NewsanLab/K9-Trainner/Hardware/ShielArchiK9V2.step

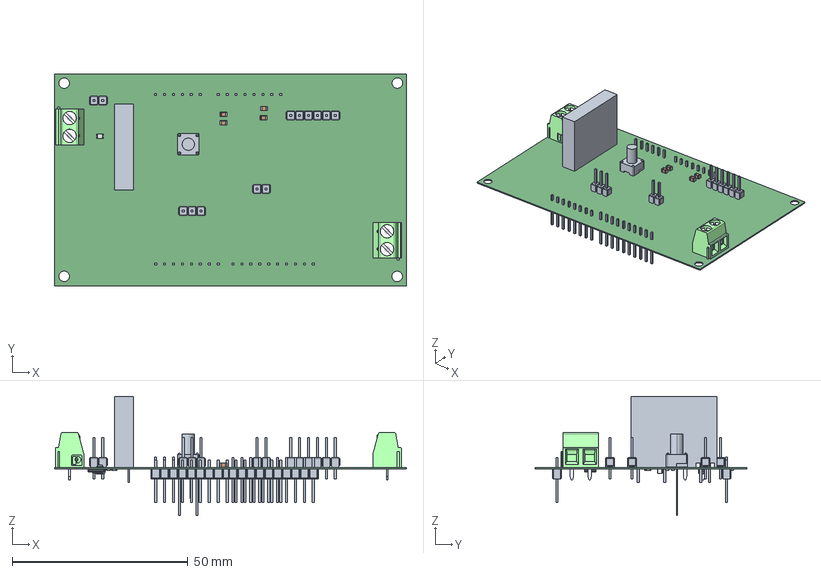
[picture p6: CAD file, 2024-08-16]
Hardware/ShielArchiK9V2.step
100.2 x 60.4 x 33.9 mm
Extruded x 19
mkdsn_1.5-2-5.08 x 2
Bourns Logo
826646-2--3DModel-STEP-1 x 2
H3MB-052D Rel石olido
Murata Logo 3 x 5
826646-3--3DModel-STEP-1
1N4148W-TP
826630-8--3DModel-STEP-1 x 2
1-826629-0--3DModel-STEP-1
826646-6--3DModel-STEP-1 x 2
