NewsanLab/K9-Trainner/Mecánica/.STL/PortaPlacas2.STL

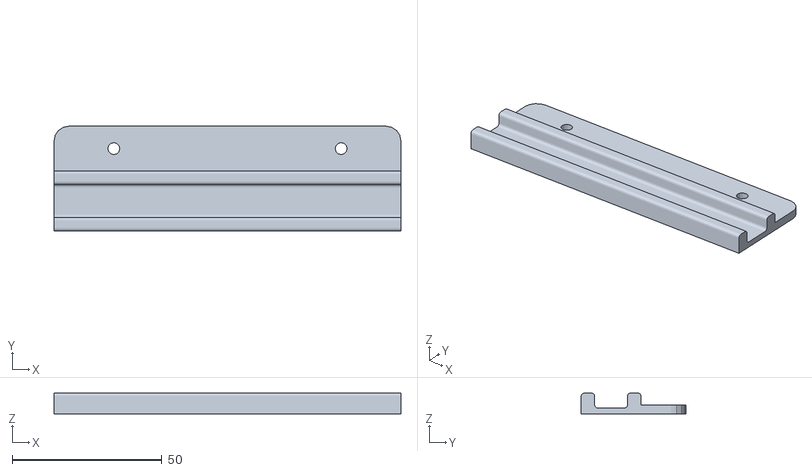
[picture p7: CAD file, 2024-08-16]
Mecánica/.STL/PortaPlacas2.STL
116.0 x 35.0 x 7.00
