NewsanLab/K9-Trainner/Mecánica/DXF/MDF-5.5mm.DXF

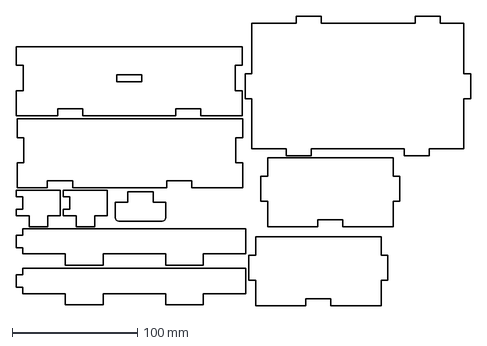
[picture p8: CAD file, 2024-08-16]
Mecánica/DXF/MDF-5.5mm.DXF
362.4 x 230.5 mm
