NewsanLab/K9-Trainner/Mecánica/SolidWorks/resorte.SLDPRT

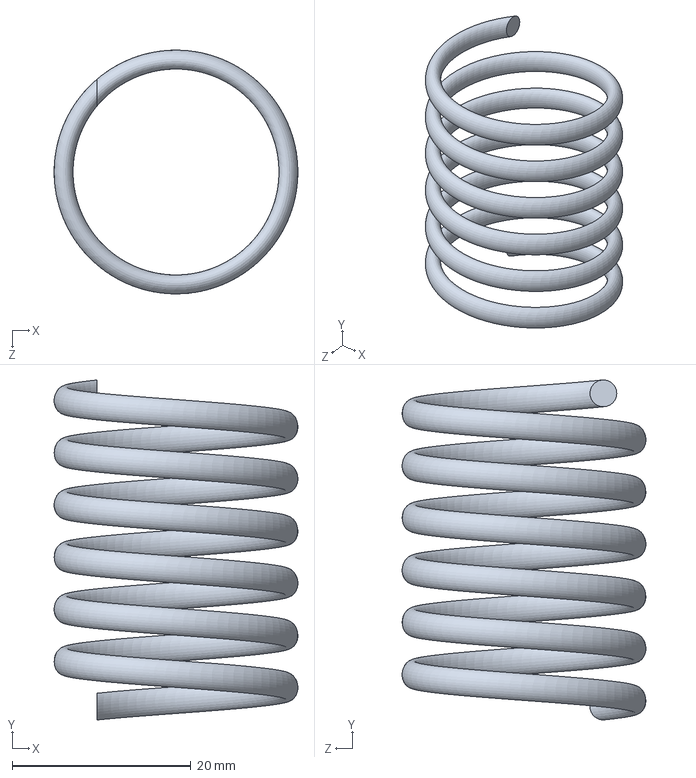
[picture p9: CAD file, 2024-08-16]
Mecánica/SolidWorks/resorte.SLDPRT
27.2 x 38.0 x 27.2 mm
