NewsanLab/K9-Trainner/Mecánica/.STL/PortaPlacas.STL

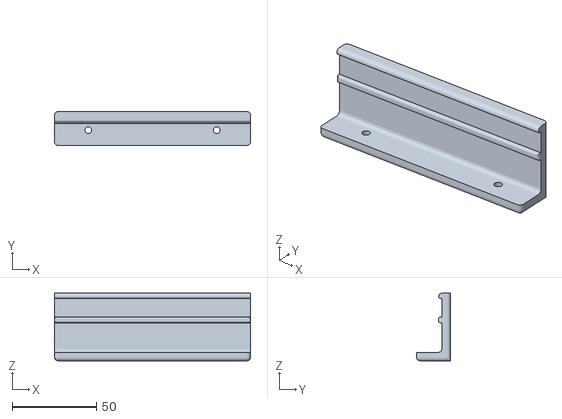
[picture p10: CAD file, 2024-08-16]
Mecánica/.STL/PortaPlacas.STL
116.0 x 20.0 x 40.0
