NewsanLab/K9-Trainner/Mecánica/DXF/Acrilico-3mm.DXF

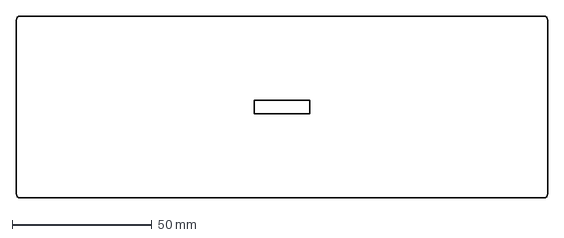
[picture p11: CAD file, 2024-08-16]
Mecánica/DXF/Acrilico-3mm.DXF
190.0 x 65.0 mm
