NewsanLab/K9-Trainner/Mecánica/SolidWorks/Angulos_Acrilico10mm.SLDPRT

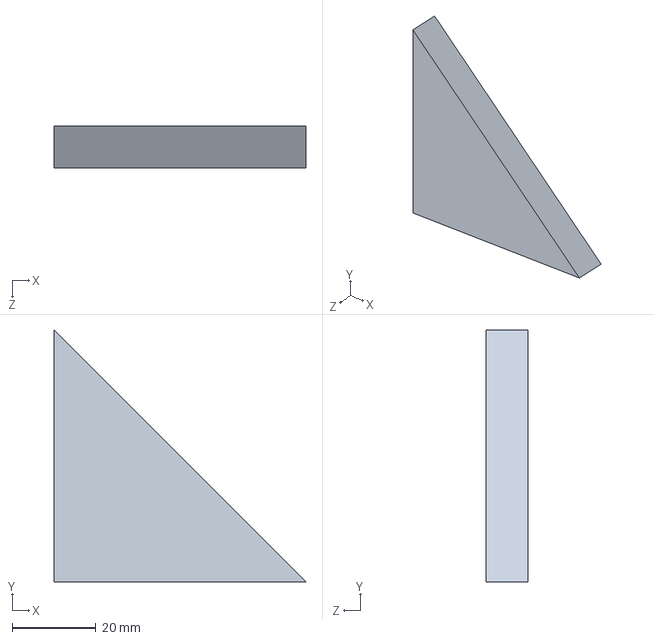
[picture p12: CAD file, 2024-08-16]
Mecánica/SolidWorks/Angulos_Acrilico10mm.SLDPRT
60.0 x 60.0 x 10.0 mm
