NewsanLab/K9-Trainner/Mecánica/.STL/PortaPilas.STL

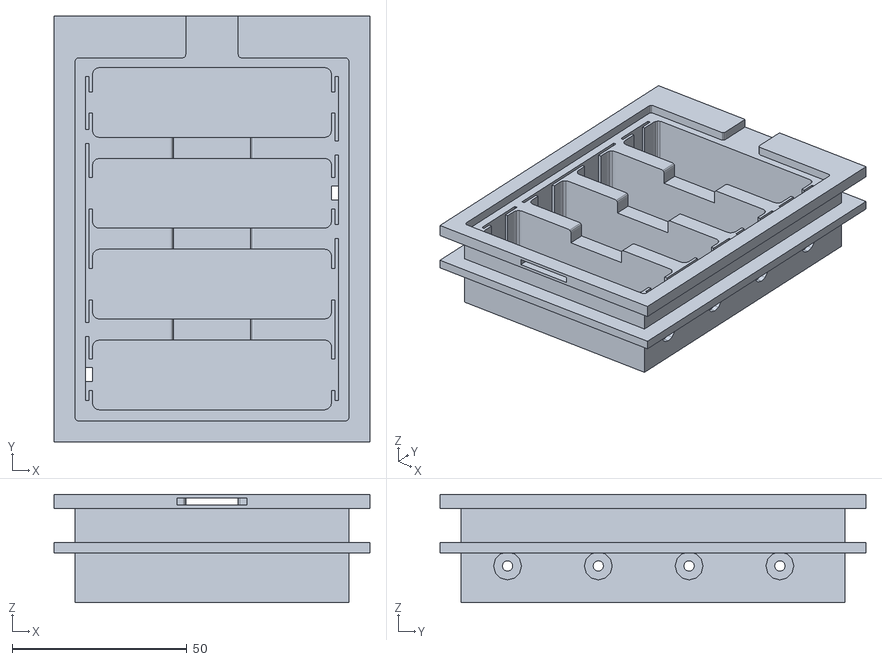
[picture p13: CAD file, 2024-08-16]
Mecánica/.STL/PortaPilas.STL
90.5 x 122.0 x 31.0
