NewsanLab/K9-Trainner/Mecánica/DXF/Acrilico-10mm.DXF

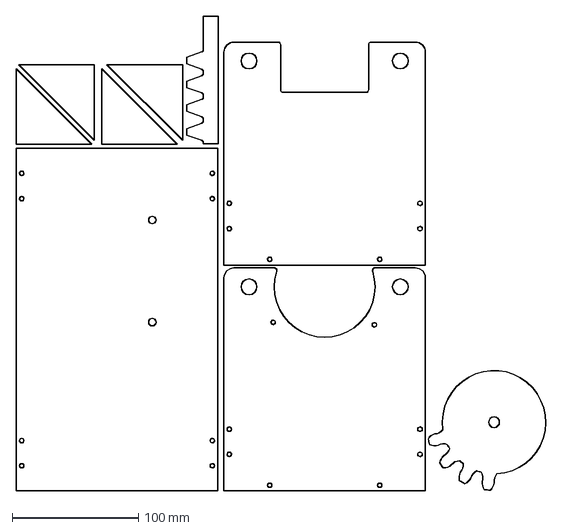
[picture p14: CAD file, 2024-08-16]
Mecánica/DXF/Acrilico-10mm.DXF
423.4 x 376.9 mm
