NewsanLab/K9-Trainner/Mecánica/SolidWorks/INTERRUPTOR SWITCH.SLDPRT

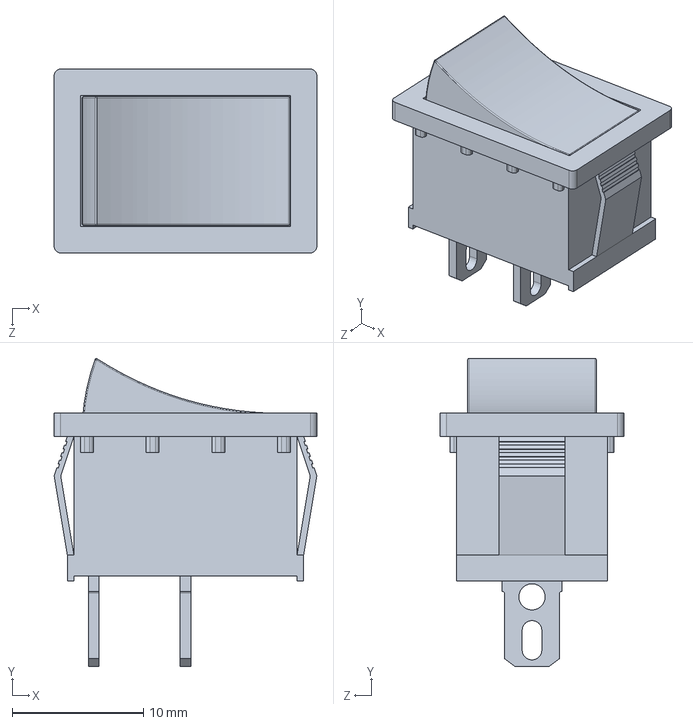
[picture p15: CAD file, 2024-08-16]
Mecánica/SolidWorks/INTERRUPTOR SWITCH.SLDPRT
20.0 x 23.4 x 14.0 mm
