NewsanLab/K9-Trainner/Mecánica/DXF/MDF-9mm.DXF

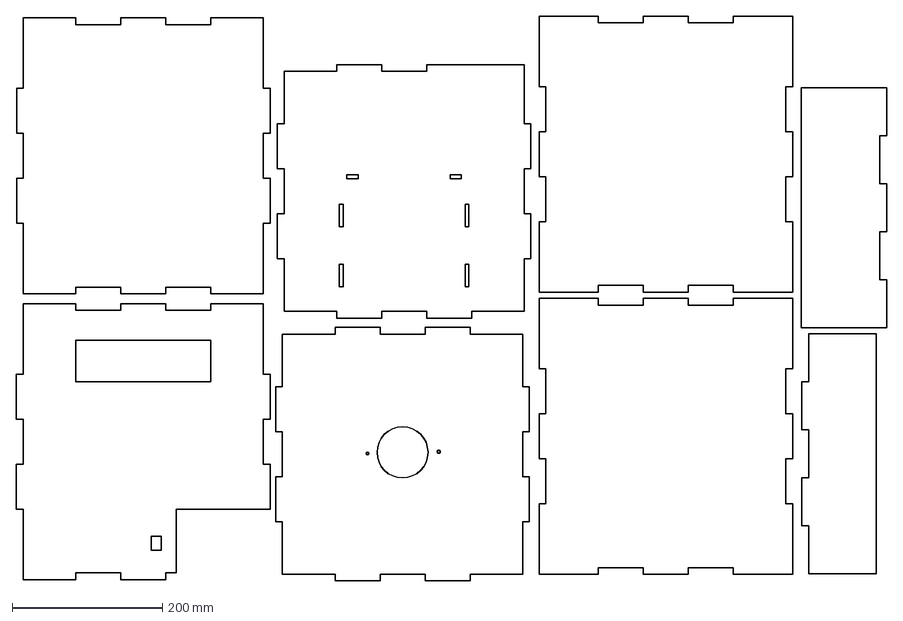
[picture p16: CAD file, 2024-08-16]
Mecánica/DXF/MDF-9mm.DXF
1160.0 x 752.8 mm
