NewsanLab/K9-Trainner/Mecánica/SolidWorks/Portapelota_Impreso3D.SLDPRT

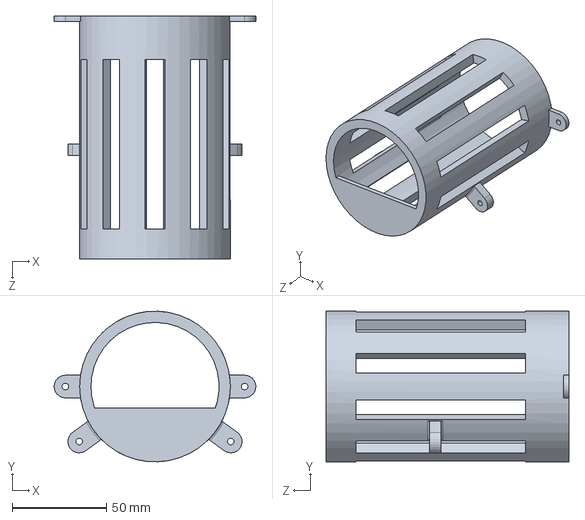
[picture p17: CAD file, 2024-08-16]
Mecánica/SolidWorks/Portapelota_Impreso3D.SLDPRT
107.1 x 79.9 x 129.0 mm
