NewsanLab/K9-Trainner/Mecánica/SolidWorks/Baterias.SLDPRT

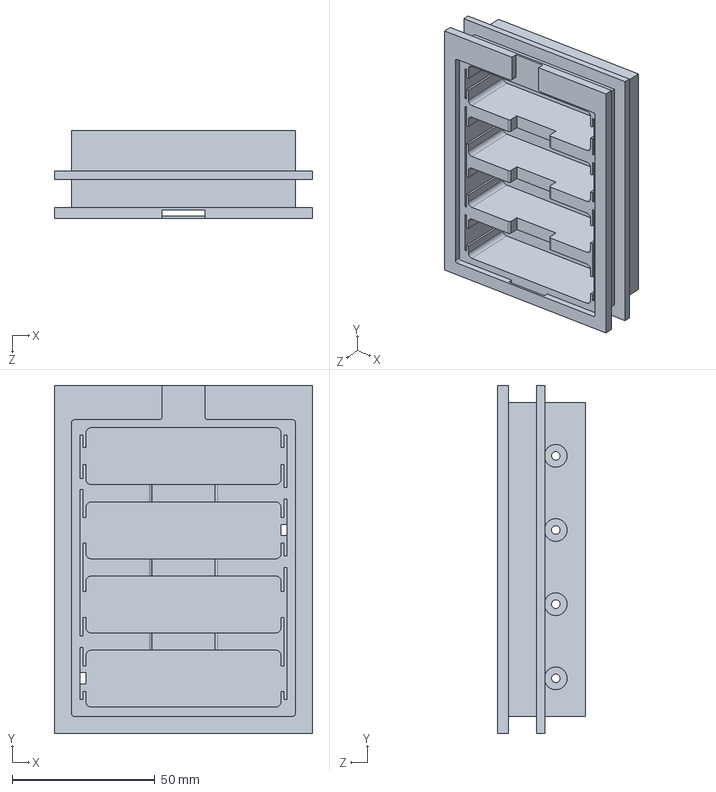
[picture p18: CAD file, 2024-08-16]
Mecánica/SolidWorks/Baterias.SLDPRT
90.5 x 122.0 x 31.0 mm
