NewsanLab/K9-Trainner/Mecánica/SolidWorks/Eje_final.SLDPRT

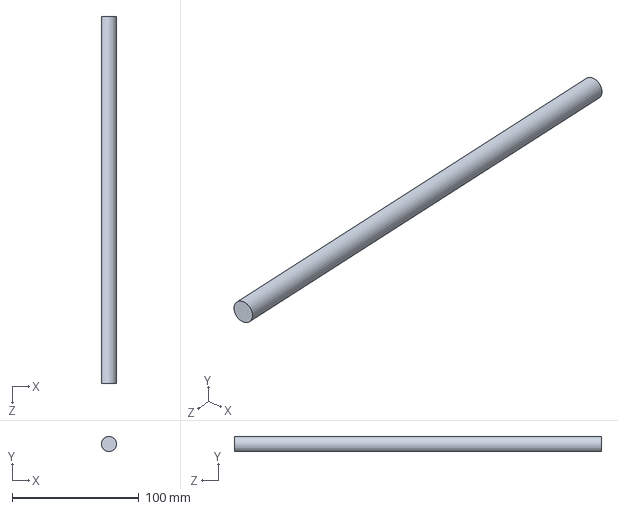
[picture p19: CAD file, 2024-08-16]
Mecánica/SolidWorks/Eje_final.SLDPRT
12.0 x 12.0 x 290.0 mm
