NewsanLab/K9-Trainner/Mecánica/SolidWorks/Portacremallera_Impreso3D.SLDPRT

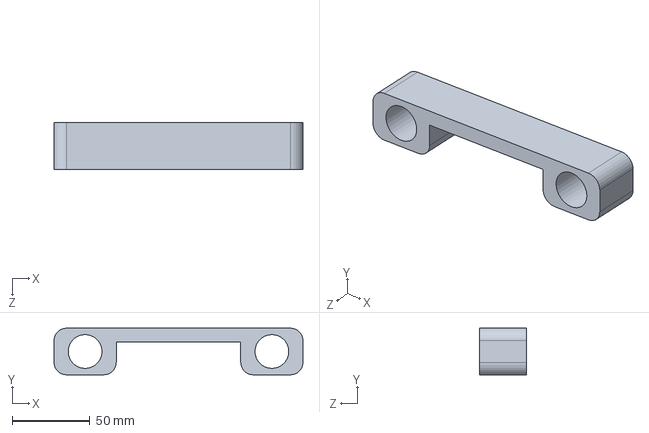
[picture p20: CAD file, 2024-08-16]
Mecánica/SolidWorks/Portacremallera_Impreso3D.SLDPRT
160.0 x 30.0 x 30.0 mm
