NewsanLab/K9-Trainner/Mecánica/SolidWorks/Base_Acrilico10mm.SLDPRT

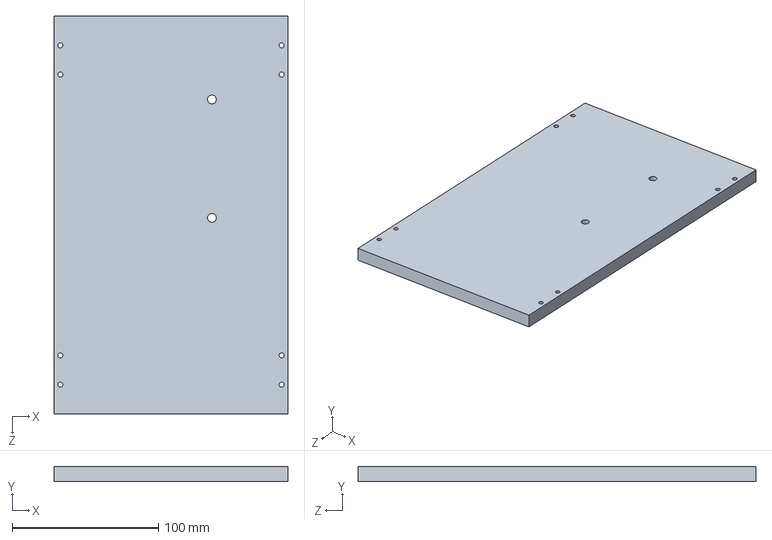
[picture p21: CAD file, 2024-08-16]
Mecánica/SolidWorks/Base_Acrilico10mm.SLDPRT
160.0 x 10.0 x 272.0 mm
