NewsanLab/K9-Trainner/Mecánica/SolidWorks/Cajon.trasero_MDF5.5mm.SLDPRT

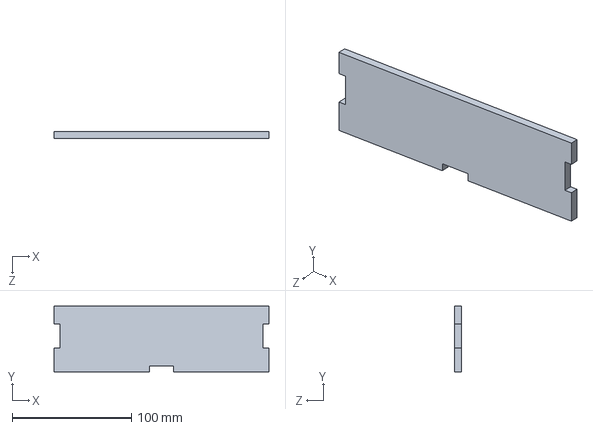
[picture p22: CAD file, 2024-08-16]
Mecánica/SolidWorks/Cajon.trasero_MDF5.5mm.SLDPRT
180.0 x 55.0 x 5.50 mm
