NewsanLab/K9-Trainner/Mecánica/SolidWorks/Estructura delantera_Acrilico10mm.SLDPRT

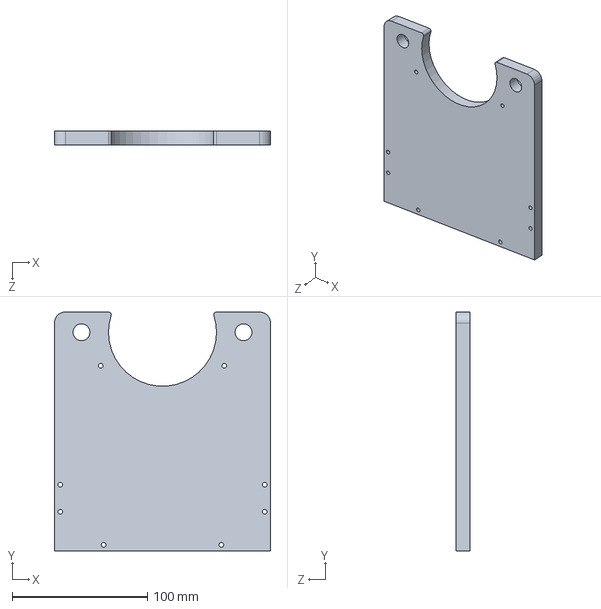
[picture p23: CAD file, 2024-08-16]
Mecánica/SolidWorks/Estructura delantera_Acrilico10mm.SLDPRT
160.0 x 177.0 x 10.0 mm
