NewsanLab/K9-Trainner/Mecánica/SolidWorks/Buje.SLDPRT

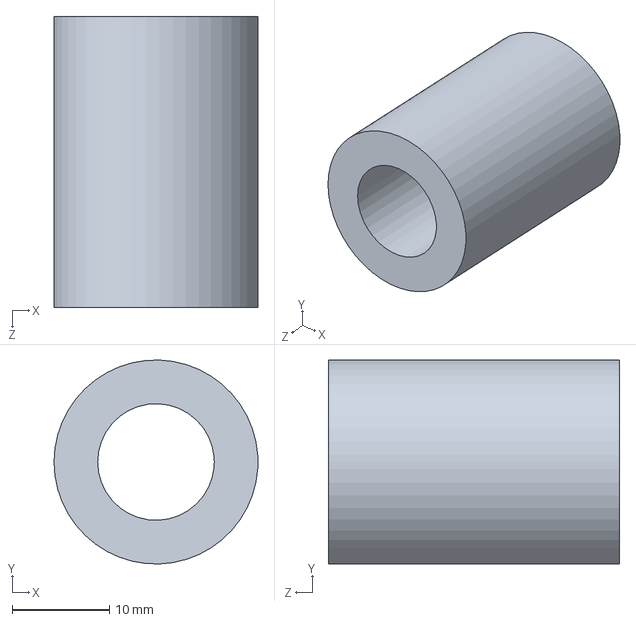
[picture p24: CAD file, 2024-08-16]
Mecánica/SolidWorks/Buje.SLDPRT
21.0 x 21.0 x 30.0 mm
