NewsanLab/K9-Trainner/Mecánica/SolidWorks/Cajon.manija_MDF5.5mm.SLDPRT

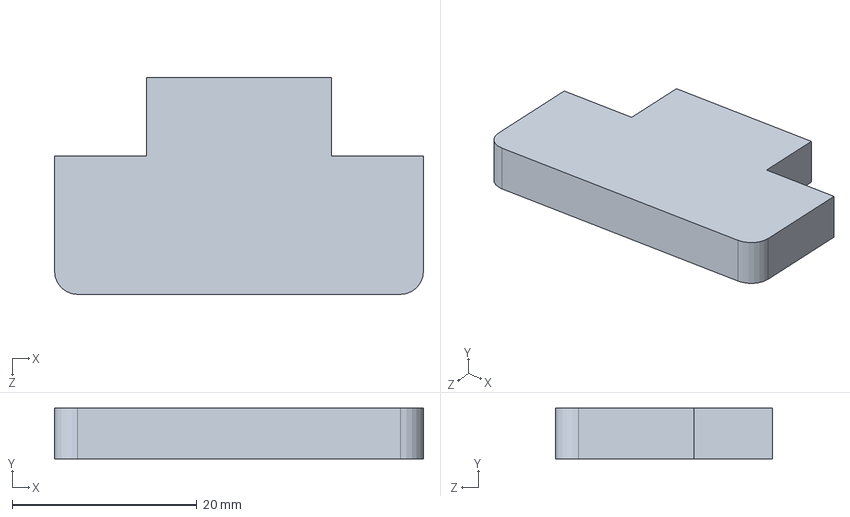
[picture p25: CAD file, 2024-08-16]
Mecánica/SolidWorks/Cajon.manija_MDF5.5mm.SLDPRT
40.0 x 5.50 x 23.5 mm
