NewsanLab/K9-Trainner/Mecánica/SolidWorks/Cajon.lateral_MDF5.5mm.SLDPRT

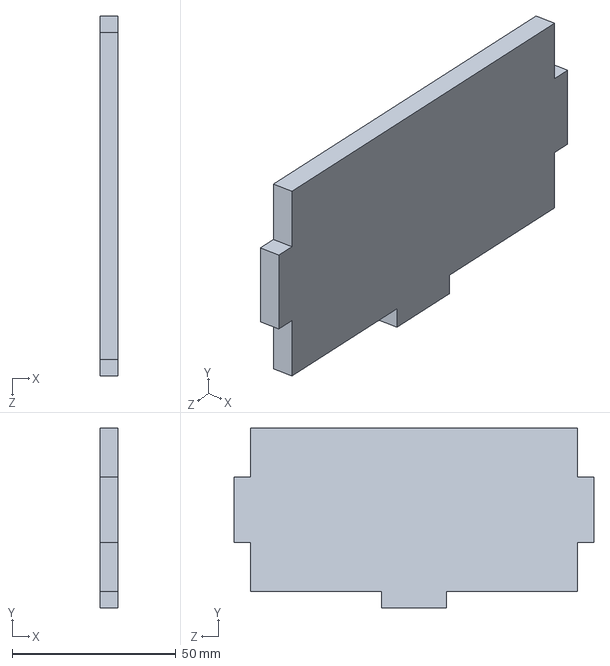
[picture p26: CAD file, 2024-08-16]
Mecánica/SolidWorks/Cajon.lateral_MDF5.5mm.SLDPRT
5.50 x 55.0 x 110.0 mm
