NewsanLab/K9-Trainner/Mecánica/SolidWorks/Cremallera_Acrilico10mm.SLDPRT

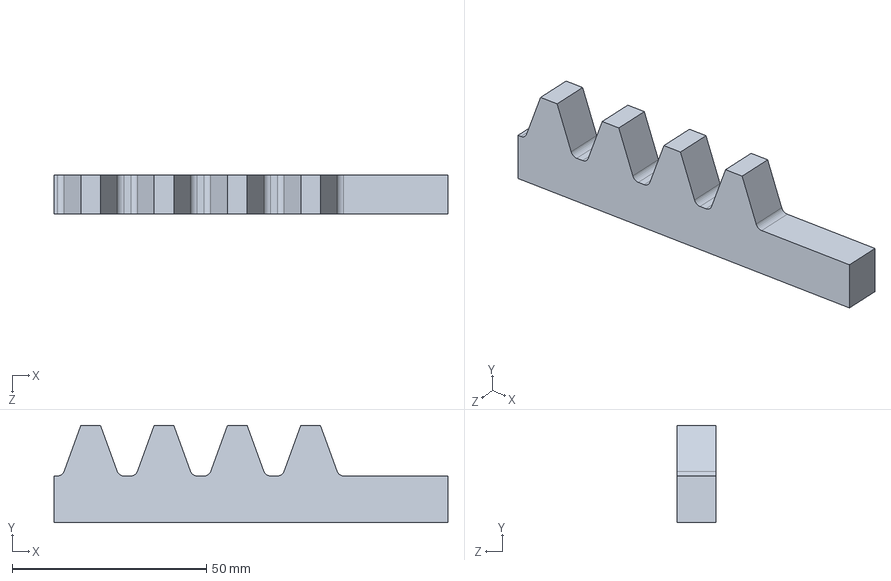
[picture p27: CAD file, 2024-08-16]
Mecánica/SolidWorks/Cremallera_Acrilico10mm.SLDPRT
101.3 x 25.0 x 10.0 mm
