NewsanLab/K9-Trainner/Mecánica/SolidWorks/CubreElectrónica.mdf.SLDPRT

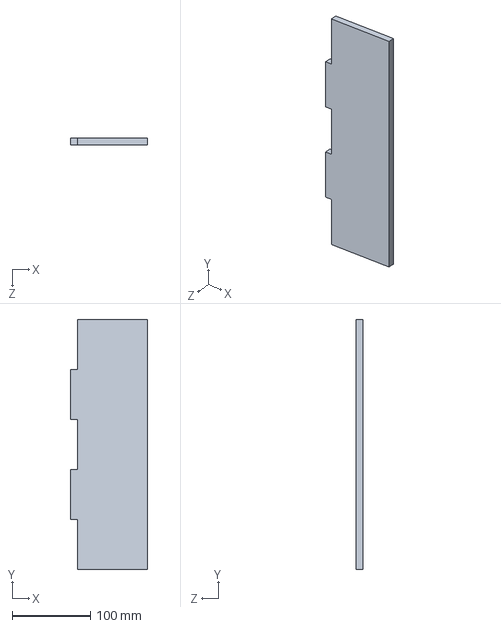
[picture p29: CAD file, 2024-08-16]
Mecánica/SolidWorks/CubreElectrónica.mdf.SLDPRT
99.0 x 320.0 x 9.00 mm
