NewsanLab/K9-Trainner/Mecánica/SolidWorks/CAJA_LATERAL3 _MDF9mm.SLDPRT

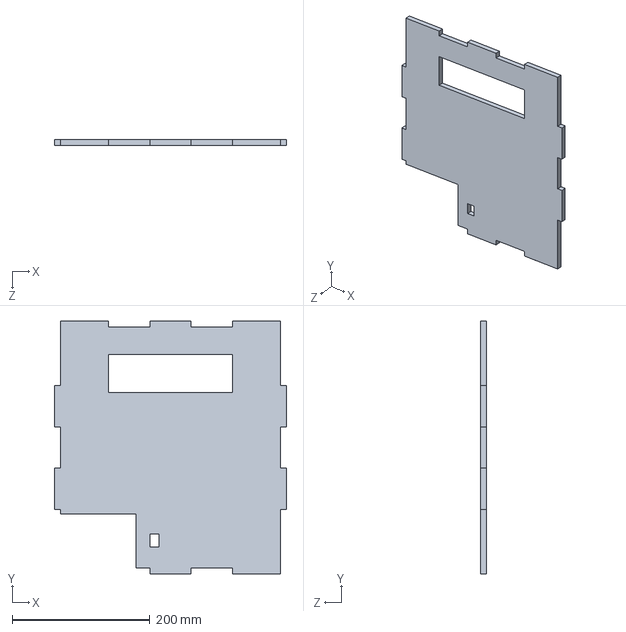
[picture p31: CAD file, 2024-08-16]
Mecánica/SolidWorks/CAJA_LATERAL3 _MDF9mm.SLDPRT
338.0 x 368.0 x 9.00 mm
