NewsanLab/K9-Trainner/Mecánica/SolidWorks/Cajon.base_MDF5.5mm.SLDPRT

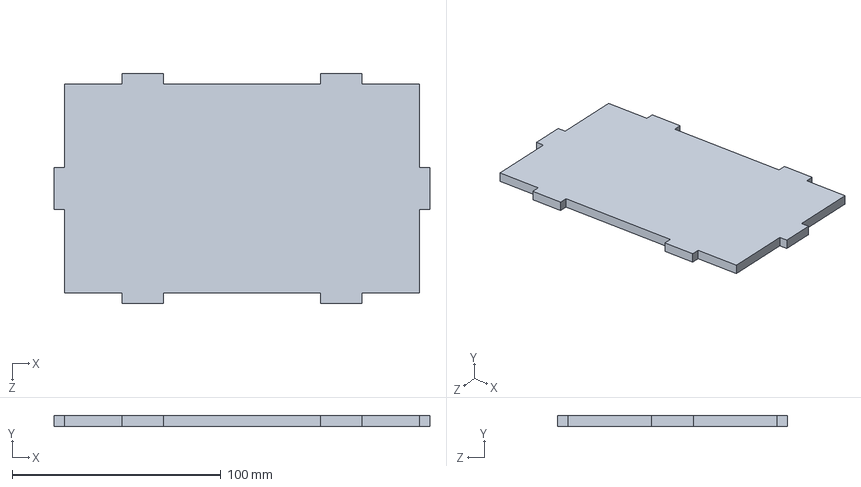
[picture p32: CAD file, 2024-08-16]
Mecánica/SolidWorks/Cajon.base_MDF5.5mm.SLDPRT
180.0 x 5.50 x 110.0 mm
