NewsanLab/K9-Trainner/Mecánica/SolidWorks/Cajon.frente_Acrilico3mm.SLDPRT

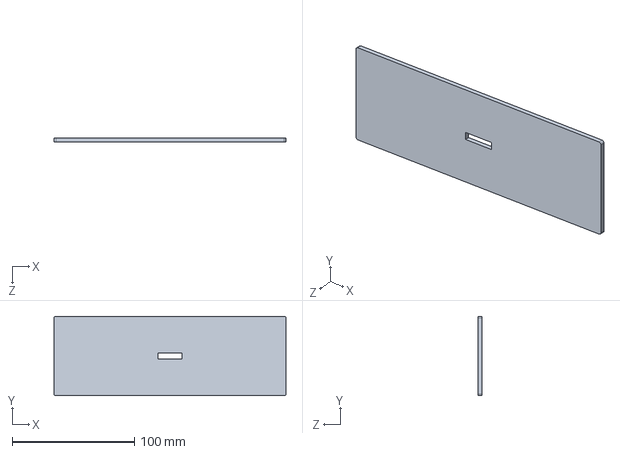
[picture p33: CAD file, 2024-08-16]
Mecánica/SolidWorks/Cajon.frente_Acrilico3mm.SLDPRT
190.0 x 65.0 x 3.00 mm
