NewsanLab/K9-Trainner/Mecánica/SolidWorks/Piñon_Acrilico10mm.SLDPRT

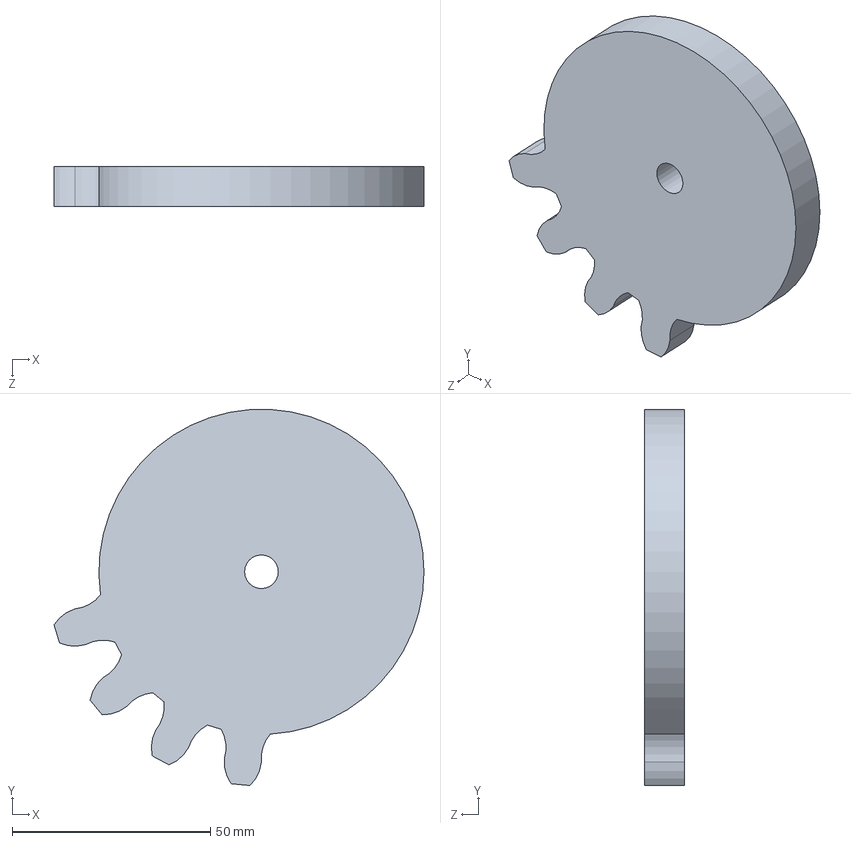
[picture p34: CAD file, 2024-08-16]
Mecánica/SolidWorks/Piñon_Acrilico10mm.SLDPRT
93.3 x 94.9 x 10.0 mm
