NewsanLab/K9-Trainner/Mecánica/SolidWorks/CubreElectrónica2.SLDPRT

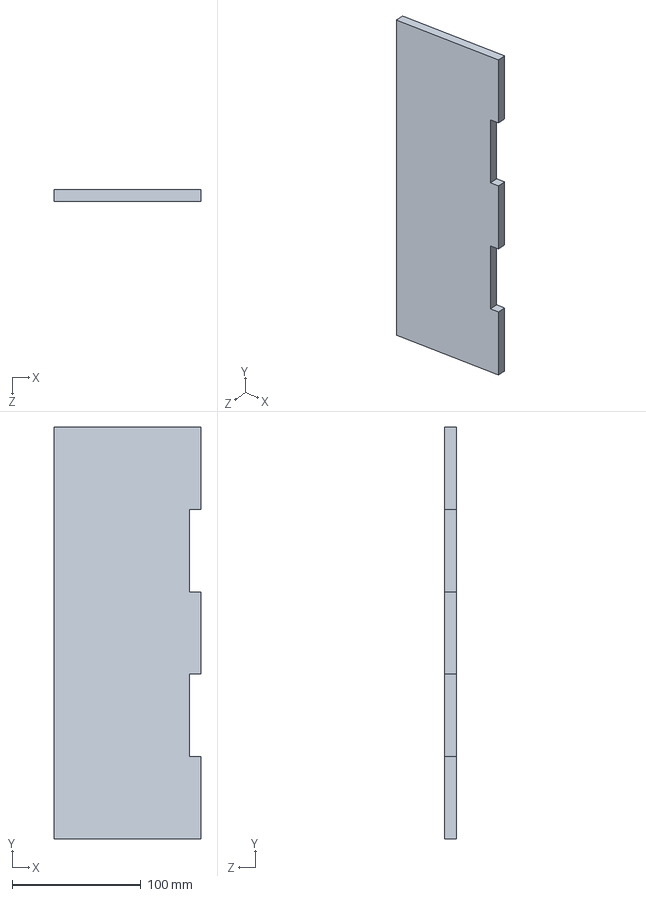
[picture p35: CAD file, 2024-08-16]
Mecánica/SolidWorks/CubreElectrónica2.SLDPRT
114.0 x 320.0 x 9.00 mm
