NewsanLab/K9-Trainner/Mecánica/SolidWorks/SOPORTE1_MDF5.5mm.SLDPRT

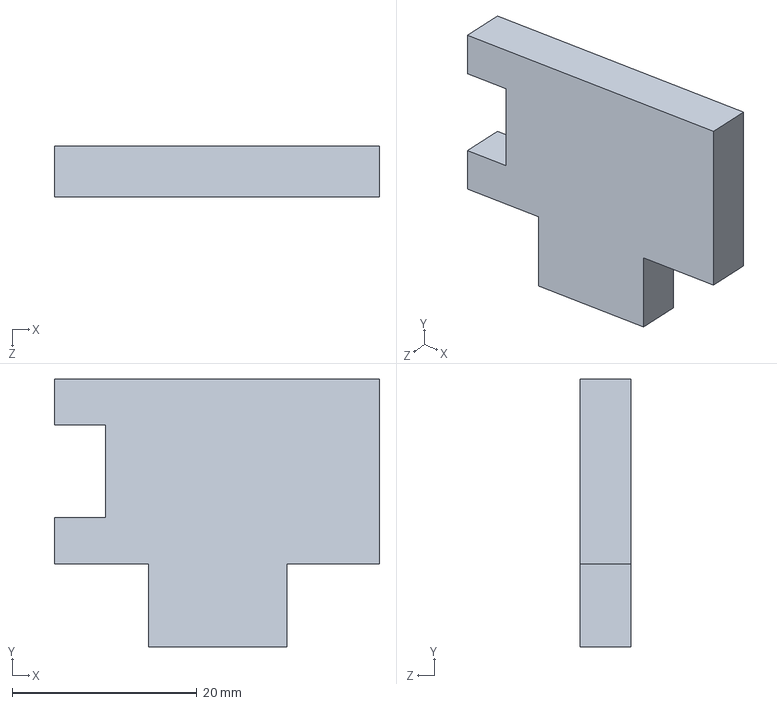
[picture p36: CAD file, 2024-08-16]
Mecánica/SolidWorks/SOPORTE1_MDF5.5mm.SLDPRT
35.2 x 29.0 x 5.50 mm
