NewsanLab/K9-Trainner/Mecánica/SolidWorks/MotorLimpiaparabrisas.STEP

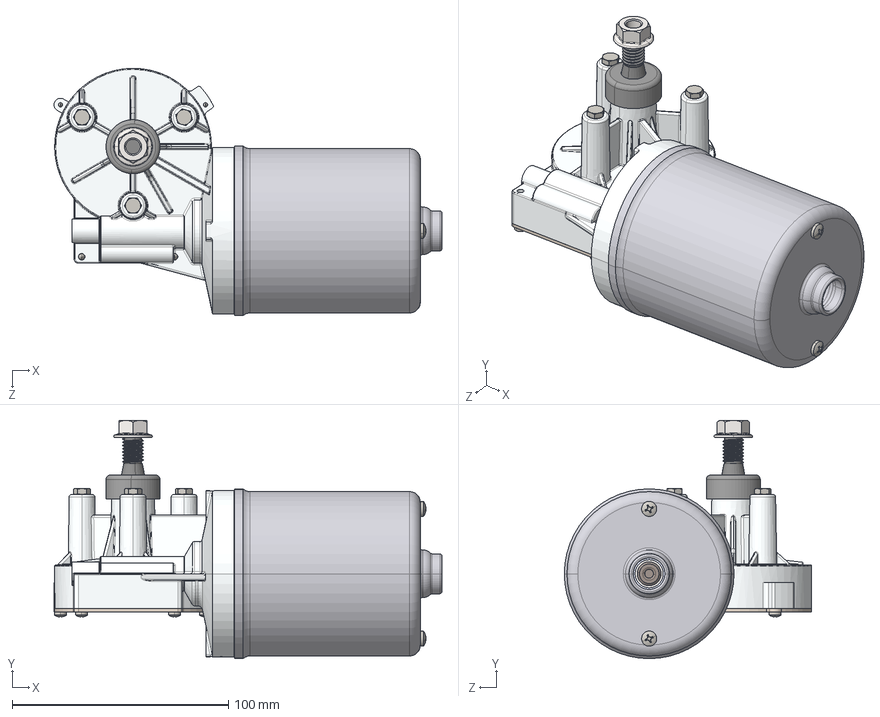
[picture p37: CAD file, 2024-08-16]
Mecánica/SolidWorks/MotorLimpiaparabrisas.STEP
179.5 x 110.2 x 114.4 mm
Supertrans
Supertrans_Carcaza
Supertrans_Tapa
sheet metal screws_dinSupertrans_Tapping screw DIN 7049-ST2.9x6.5-C-H-N x 4
hex bolt gradeab_dinSupertrans_DIN EN 24014 - M4 x 25 x 14-N x 3
slotted headless screw_dinSupertrans_DIN 427 M8 x 16 --- 9.6N
Buje
Perno
Trasero
BujeTrasero
Eje
Goma
hex flange nut_dinSupertrans_Hexagon Flange Nut DIN 6923 - M8 - N
sheet metal screws_dinSupertrans2_Tapping screw DIN 7049-ST3.5x9.5-C-H-N x 2
