NewsanLab/K9-Trainner/Mecánica/SolidWorks/Tornillos.SLDPRT

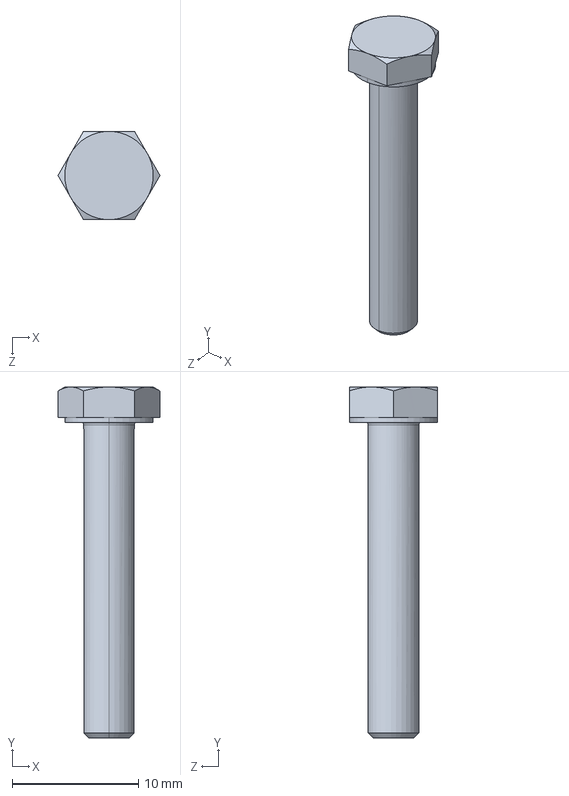
[picture p38: CAD file, 2024-08-16]
Mecánica/SolidWorks/Tornillos.SLDPRT
8.08 x 27.8 x 7.00 mm
