NewsanLab/K9-Trainner/Mecánica/SolidWorks/SoporteMotor.SLDPRT

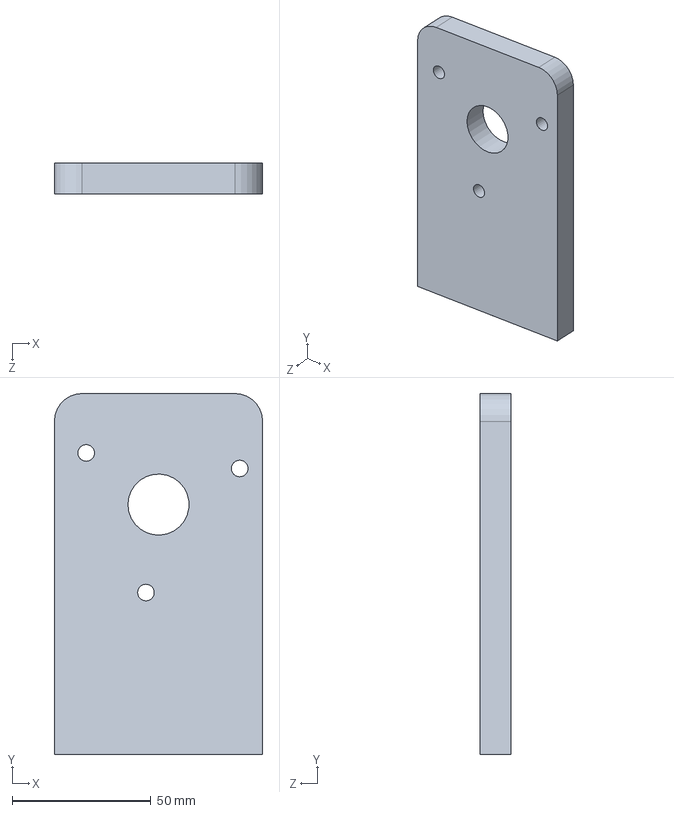
[picture p39: CAD file, 2024-08-16]
Mecánica/SolidWorks/SoporteMotor.SLDPRT
75.0 x 130.0 x 11.0 mm
