NewsanLab/K9-Trainner/Mecánica/SolidWorks/TAPA_CAJA.SLDPRT

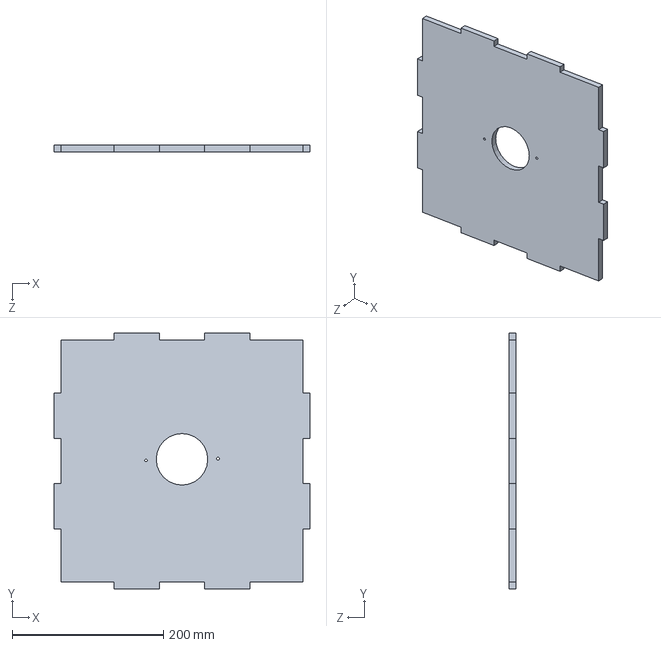
[picture p40: CAD file, 2024-08-16]
Mecánica/SolidWorks/TAPA_CAJA.SLDPRT
338.0 x 338.0 x 9.00 mm
