NewsanLab/K9-Trainner/Mecánica/SolidWorks/SOPORTE2_MDF5.5mm.SLDPRT

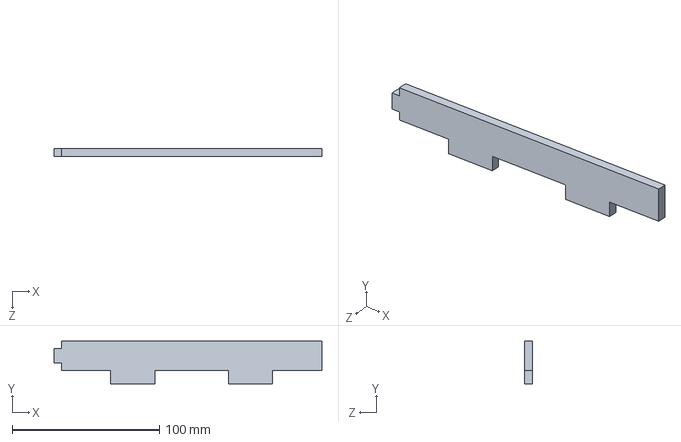
[picture p41: CAD file, 2024-08-16]
Mecánica/SolidWorks/SOPORTE2_MDF5.5mm.SLDPRT
182.0 x 29.0 x 5.50 mm
