NewsanLab/K9-Trainner/Mecánica/SolidWorks/BASE_CAJA_MDF.SLDPRT

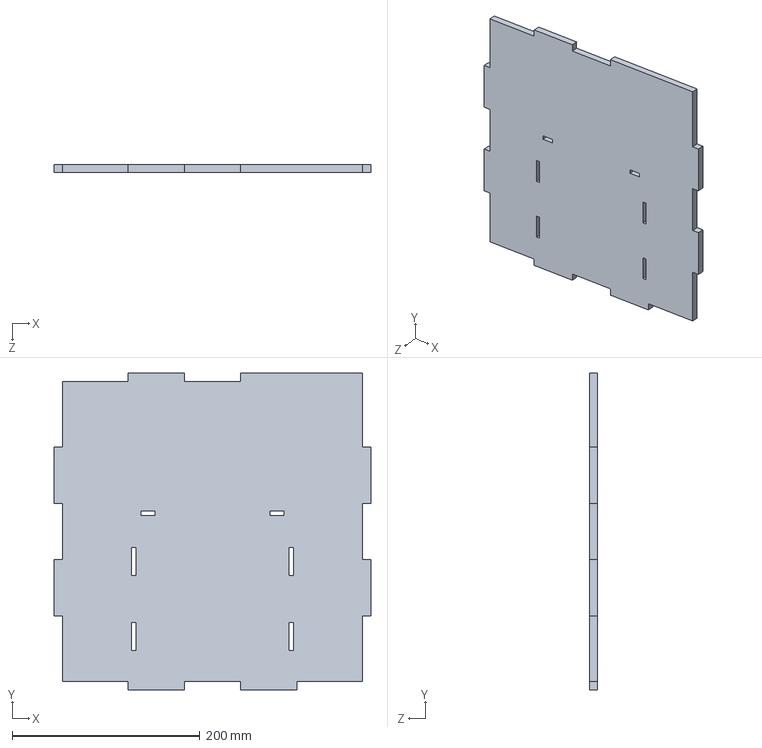
[picture p42: CAD file, 2024-08-16]
Mecánica/SolidWorks/BASE_CAJA_MDF.SLDPRT
338.0 x 338.0 x 9.00 mm
