NewsanLab/K9-Trainner/(list of files, cad)

Other CAD files:
Mecánica/SolidWorks/PortaPlacasBase.SLDPRT
Mecánica/SolidWorks/Cajon.delantero_MDF5.5mm.SLDPRT
Mecánica/SolidWorks/CAJA_LATERAL4_MDF9mm.SLDPRT
Mecánica/SolidWorks/PortaPlacaSuperior.SLDPRT
Mecánica/.STL/Portacremallera_Impreso3D.STL
Mecánica/.STL/Portapelota_Impreso3D.STL
