NewsanLab/K9-Trainner/Hardware/ShielArchiK9V2.pdf

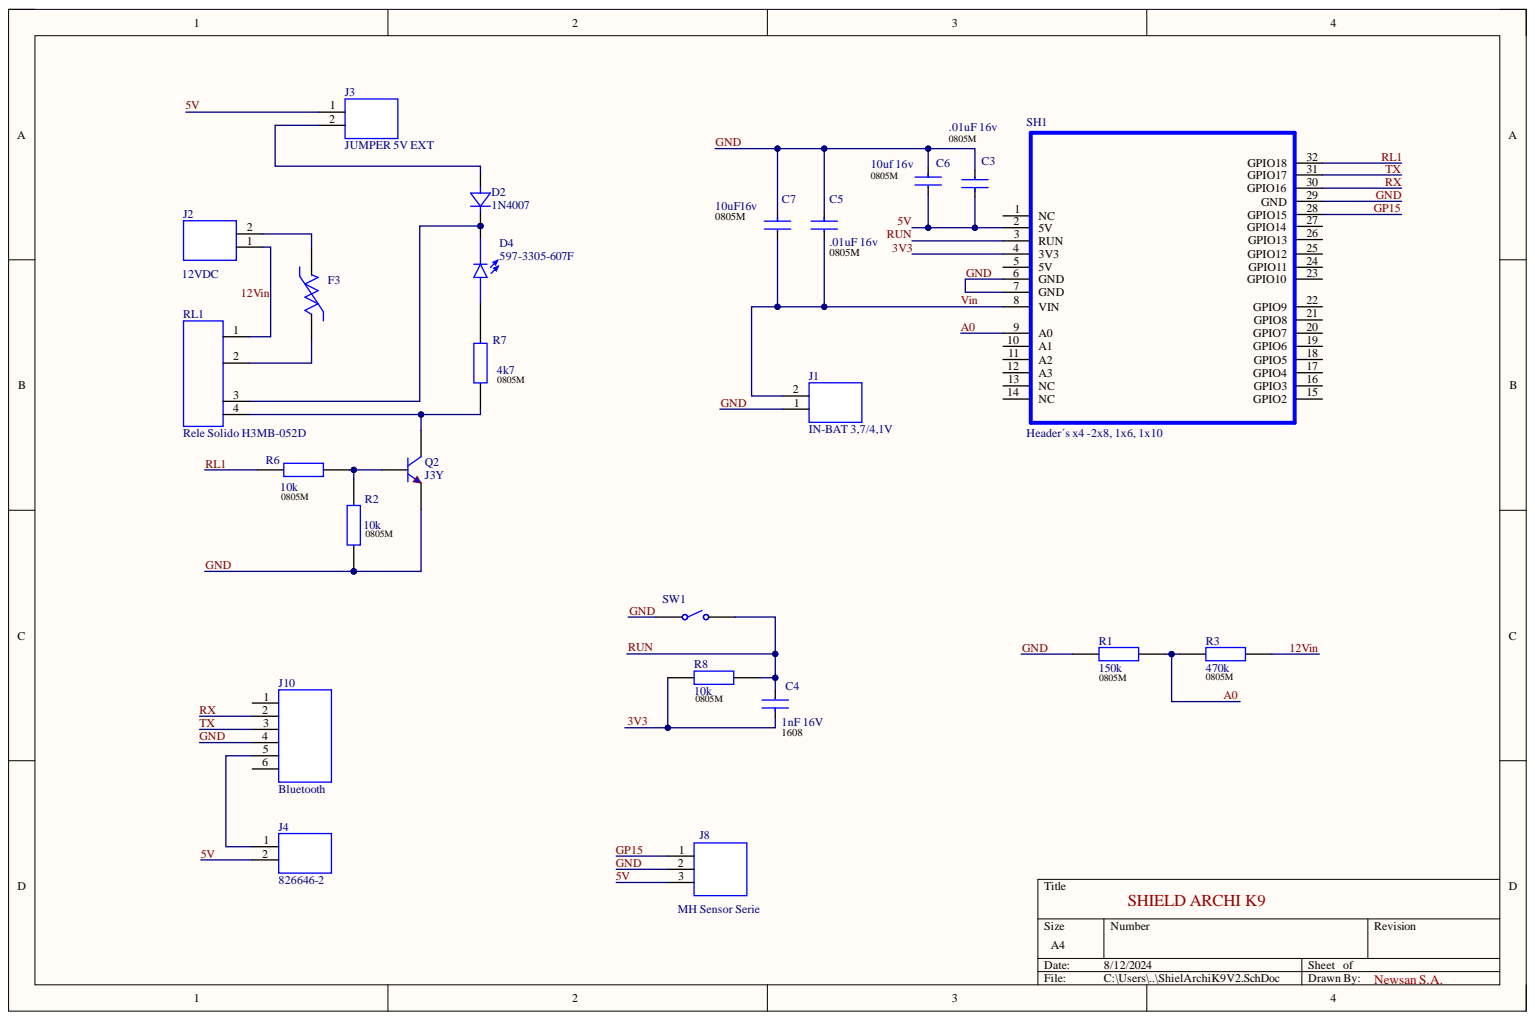
[picture p43: page 1]
