NewsanLab/K9-Trainner/(commit log)

2024-08-16 Subo archivo de código
2024-08-16 Creo archivo de Shield
2024-08-16 Creo archivo de Solid
    [BASE_CAJA_MDF.SLDPRT]
2024-08-16 Creo carpeta Mecánica
    [BASE_CAJA_MDF.SLDPRT]
2024-08-16 Creo carpeta SolidWorks
    [BASE_CAJA_MDF.SLDPRT]
2024-08-16 Creo archivo DXF para MDF 9mm
    [MDF-9mm.DXF]
2024-08-16 Creo carpeta DXF
    [MDF-9mm.DXF]
2024-08-16 Cargo archivos .DXF
    [Acrilico-10mm.DXF, Acrilico-3mm.DXF, MDF-5.5mm.DXF]
2024-08-16 Cargo archivo STL
    [Portacremallera_Impreso3D.STL]
2024-08-16 Creo carpeta .STL
    [Portacremallera_Impreso3D.STL]
2024-08-16 Cargo imagen de mecanismo
2024-08-16 Carga de imágenes Readme.md
2024-08-16 Agrego aplicación para android
